l33tl4bs/TJ-Thermal-Imager/README.md

TJ-Thermal-Imager
================

TJ (Thermal Jack) - $99 Thermal Imager 

A thumb-sized device that plugs into your iPhone / iPad / iPod Touch headphones jack and turns your iOS device into a Thermal Camera.

For more information on the [TJ project](http://hackaday.io/project/1974-TJ---%2499-Thermal-Imager)
