l33tl4bs/TJ-Thermal-Imager/hardware/TJ Gen1 Prototype.png

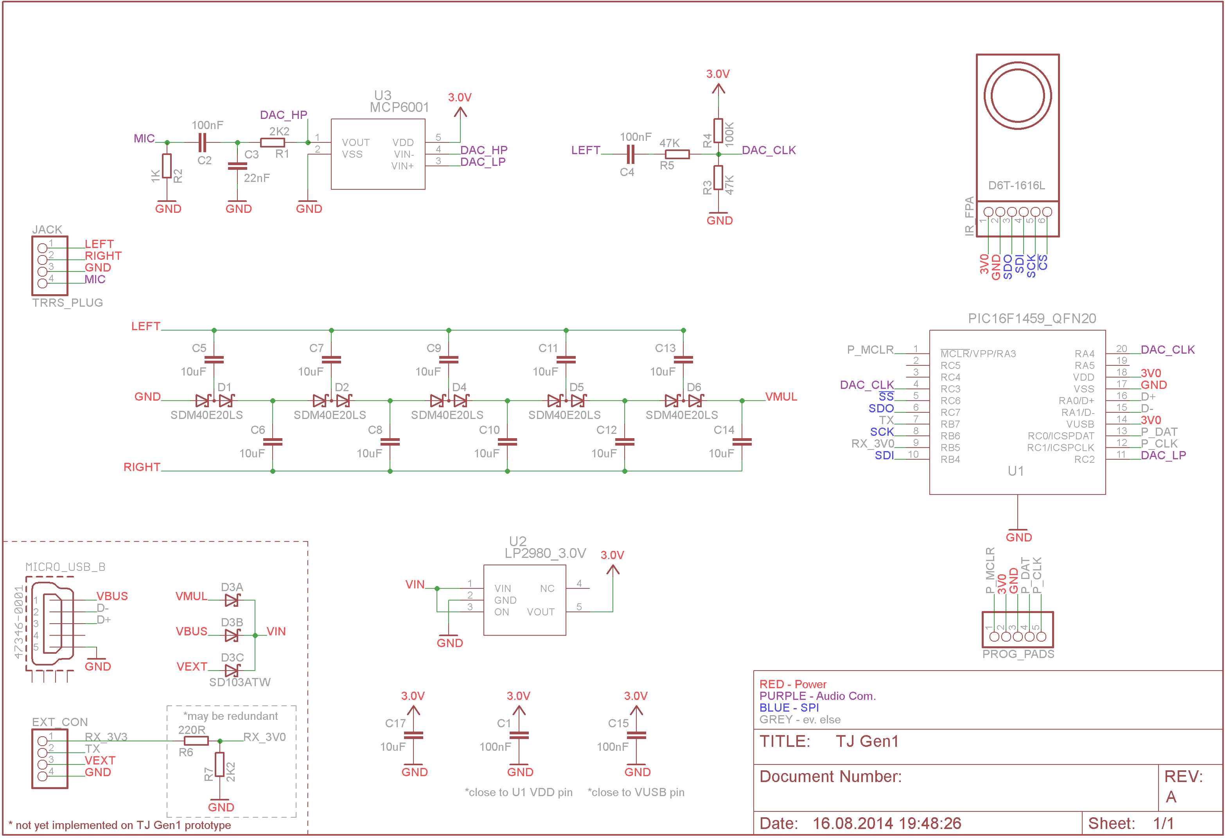
hardware/TJ Gen1 Prototype.png
