l33tl4bs/TJ-Thermal-Imager/TJ Gen1 Block Diagram.png

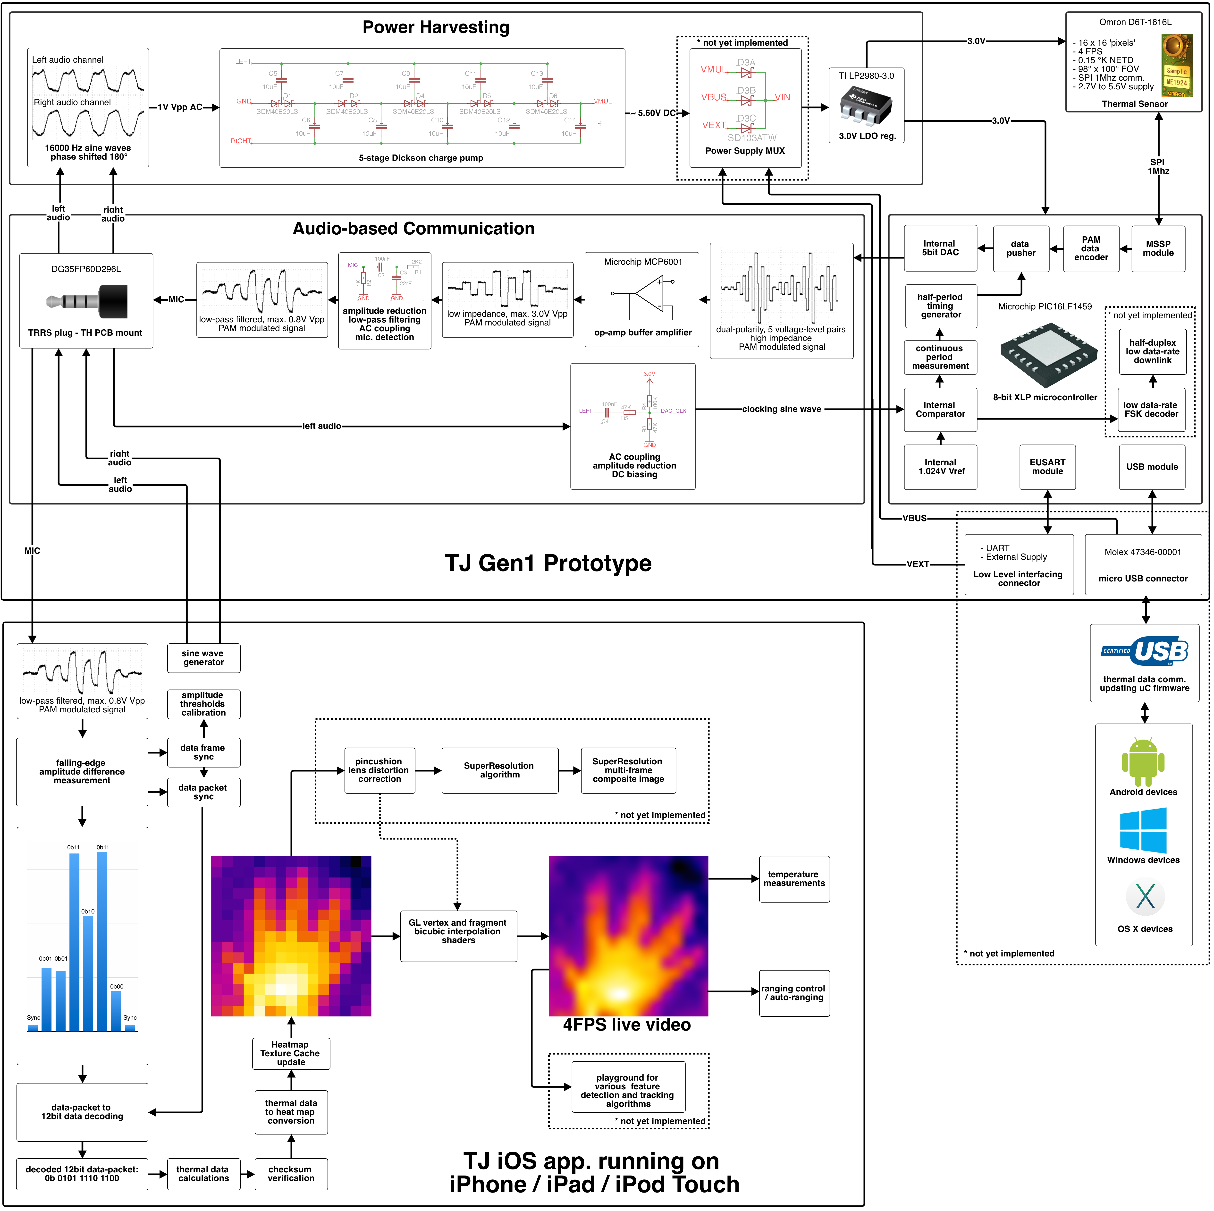
TJ Gen1 Block Diagram.png
