l33tl4bs/TJ-Thermal-Imager/hardware/TJ Gen1 Prototype.sch

## EAGLE design hardware/TJ Gen1 Prototype.sch (2014-08-19)

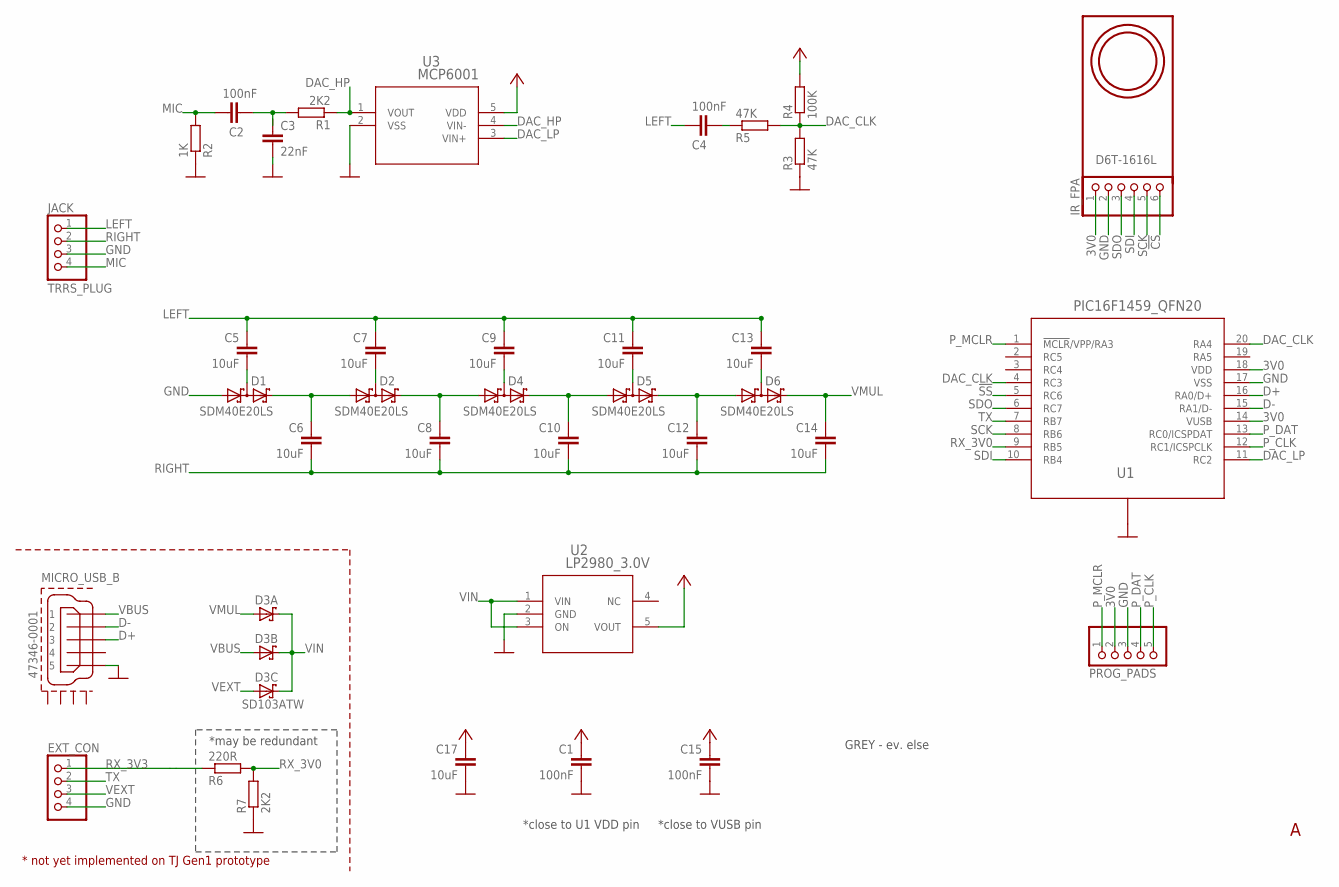
[picture p3: schematic TJ Gen1 Prototype.sch]

Parts:
C1, C2, C4, C15: 100nF; C0603
C3: 22nF; C0603
C5, C6, C7, C8, C9, C10, C11, C12, C13, C14, C17: 10uF; C0603
D1, D2, D4, D5, D6: SDM40E20LS; SOT23
D3: SD103ATW; SOT666
EXT_CON: PINHD-1X4; 1X04
IR_FPA: D6T-1616L; 1X06
JACK: TRRS_PLUG; 1X04
MICRO_USB_B: 47346-0001; MOLEX-47364-0001
PROG_PADS: PINHD-1X5; 1X05
R1, R7: 2K2; R0603
R2: 1K; R0603
R3, R5: 47K; R0603
R4: 100K; R0603
R6: 220R; R0603
U1: PIC16F1459_QFN20; QFN20_4X4MC
U2: LP2980_3.0V; MF05A
U3: MCP6001; SC70-5_MC

Connections:
3V0: IR_FPA.1, PROG_PADS.2, U1.14 (VUSB), U1.18 (VDD)
!CS: IR_FPA.6
!SS: U1.5 (RC6)
+3V3: C1.1, C15.1, C17.1, R4.2, U2.5 (VOUT), U3.5 (VDD)
D+: MICRO_USB_B.3, U1.16 (RA0/D+)
D-: MICRO_USB_B.2, U1.15 (RA1/D-)
DAC_CLK: R3.2, R4.1, R5.2, U1.4 (RC3), U1.20 (RA4)
DAC_HP: R1.1, U3.1 (VOUT), U3.4 (VIN-)
DAC_LP: U1.11 (RC2), U3.3 (VIN+)
GND: C1.2, C3.2, C15.2, C17.2, D1.1 (A1), EXT_CON.4, IR_FPA.2, JACK.3, MICRO_USB_B.5, PROG_PADS.3, R2.1, R3.1, R7.1, U1.17 (VSS), U1.21 (EP), U2.2 (GND), U3.2 (VSS)
LEFT: C4.1, C5.1, C7.1, C9.1, C11.1, C13.1, JACK.1
MIC: C2.1, JACK.4, R2.2
unnamed: C9.2, D4.3 (C1A2)
unnamed: C5.2, D1.3 (C1A2)
unnamed: C2.2, C3.1, R1.2
unnamed: C4.2, R5.1
unnamed: C7.2, D2.3 (C1A2)
unnamed: C6.1, D1.2 (C2), D2.1 (A1)
unnamed: C8.1, D2.2 (C2), D4.1 (A1)
unnamed: C10.1, D4.2 (C2), D5.1 (A1)
unnamed: C11.2, D5.3 (C1A2)
unnamed: C12.1, D5.2 (C2), D6.1 (A1)
unnamed: C13.2, D6.3 (C1A2)
P_CLK: PROG_PADS.5, U1.12 (RC1/ICSPCLK)
P_DAT: PROG_PADS.4, U1.13 (RC0/ICSPDAT)
P_MCLR: PROG_PADS.1, U1.1 (!MCLR!/VPP/RA3)
RIGHT: C6.2, C8.2, C10.2, C12.2, C14.2, JACK.2
RX_3V0: R6.2, R7.2, U1.9 (RB5)
RX_3V3: EXT_CON.1, R6.1
SCK: IR_FPA.5, U1.8 (RB6)
SDI: IR_FPA.4, U1.10 (RB4)
SDO: IR_FPA.3, U1.6 (RC7)
TX: EXT_CON.2, U1.7 (RB7)
VBUS: D3.2 (A), MICRO_USB_B.1
VEXT: D3.3 (A), EXT_CON.3
VIN: D3.4 (C), D3.5 (C), D3.6 (C), U2.1 (VIN), U2.3 (ON)
VMUL: C14.1, D3.1 (A), D6.2 (C2)

Notes on the sheet:
*close to U1 VDD pin
*close to VUSB pin
* not yet implemented on TJ Gen1 prototype
*may be redundant
GREY - ev. else
